dewayne57/Coil_Winder/Resources/Arduino-CNC-Shield-Schematics-V3.XX_.jpg

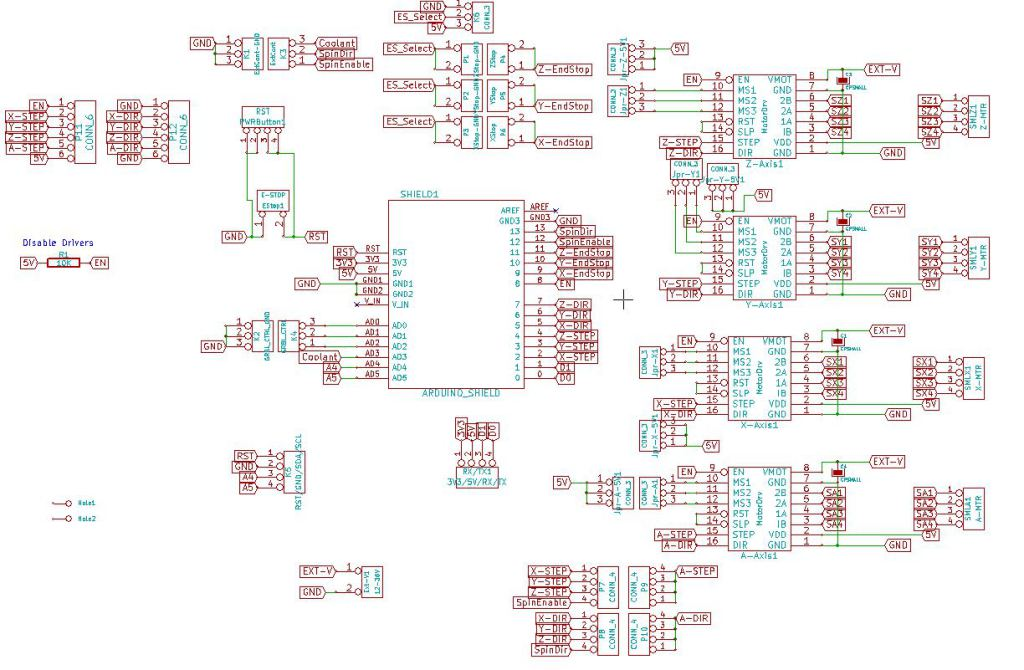
Resources/Arduino-CNC-Shield-Schematics-V3.XX_.jpg
