dewayne57/Coil_Winder/Resources/PH264M,PH265M,PH266M,PH268M.pdf

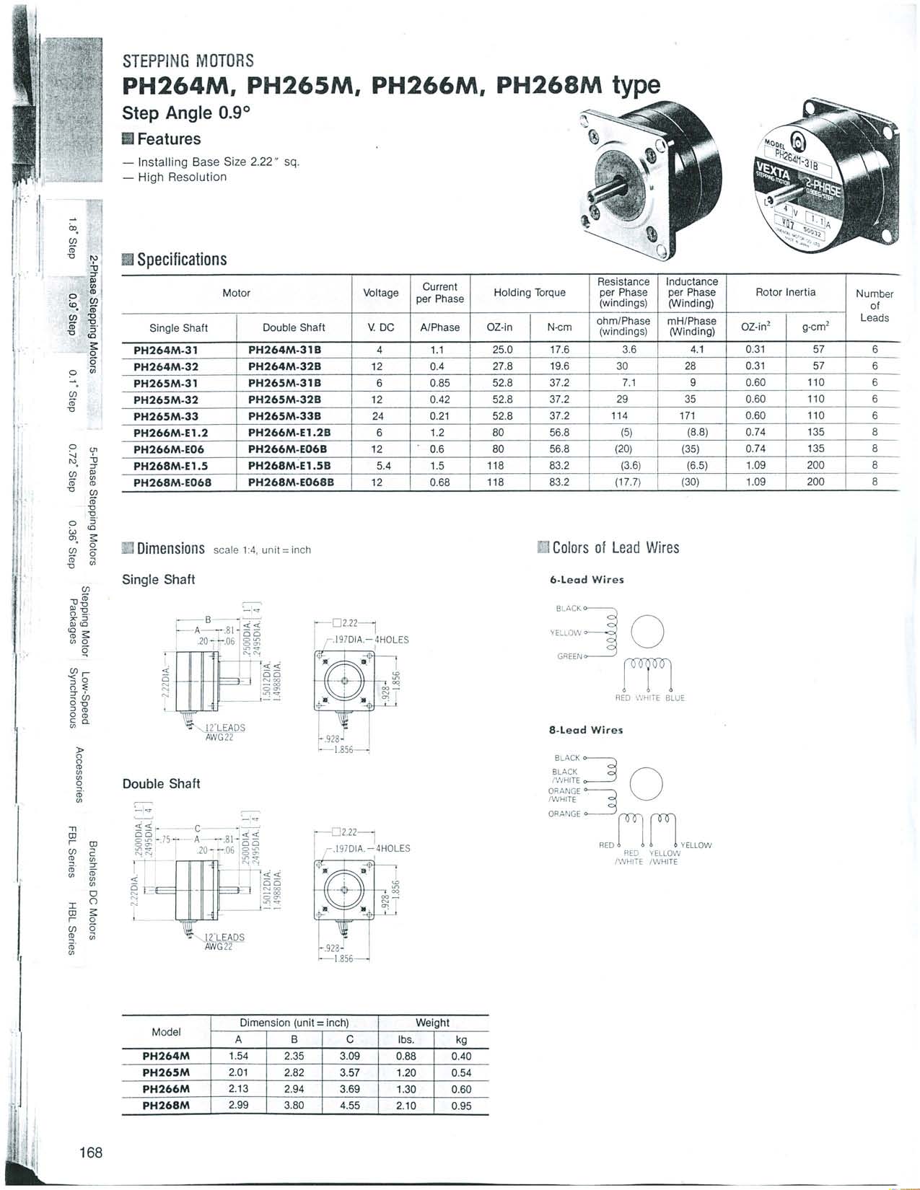
[picture p2: page 1]
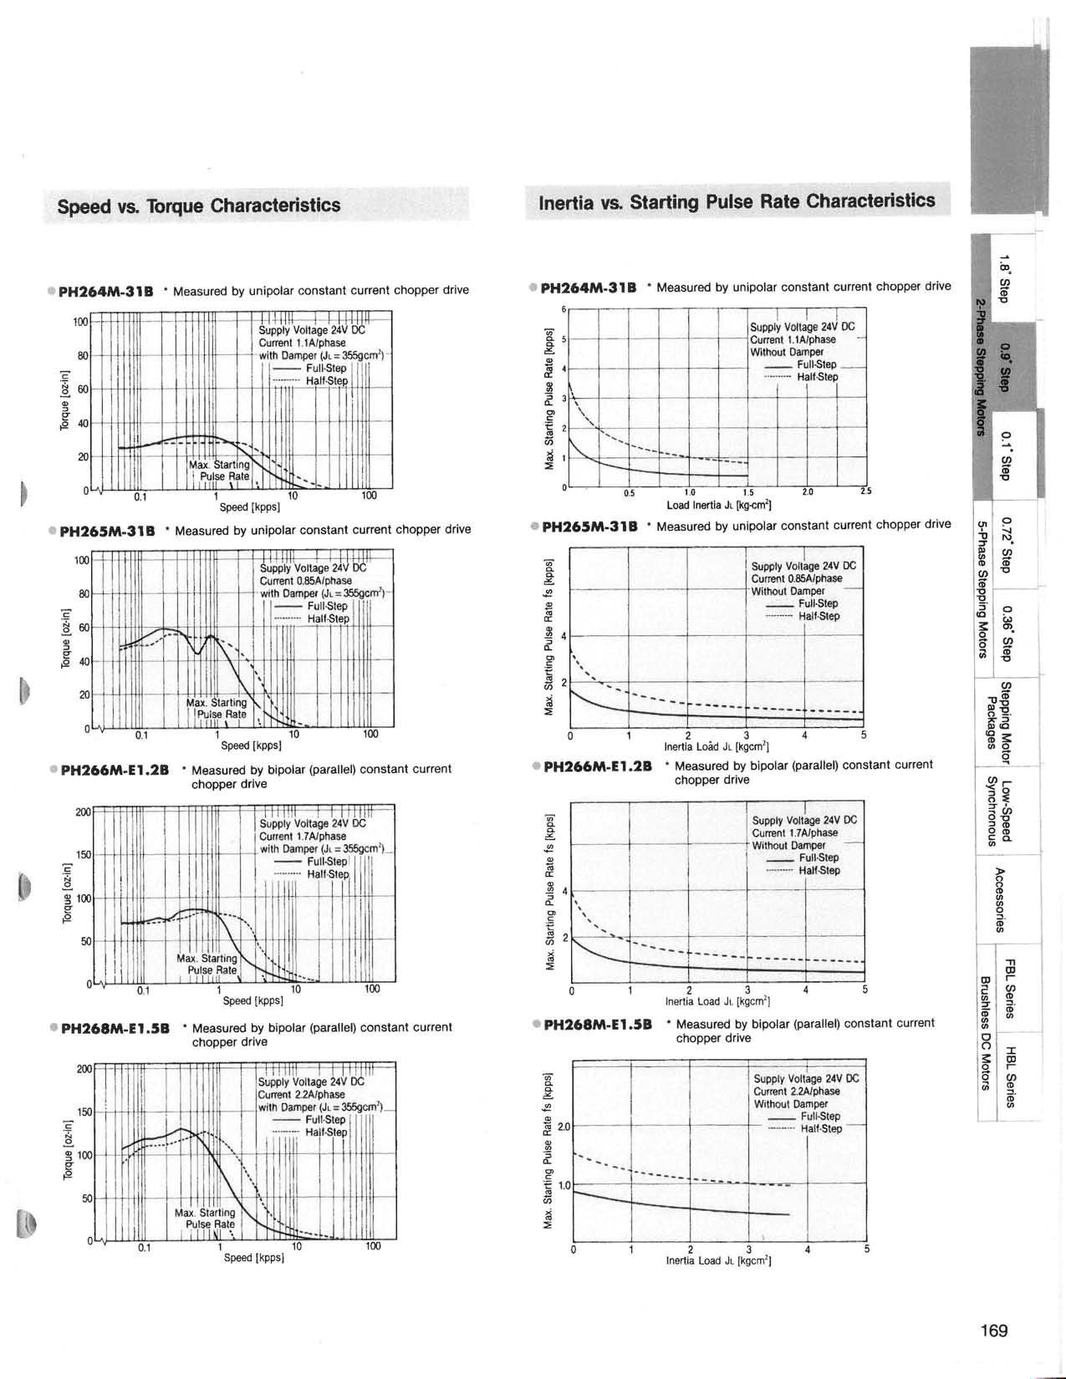
[picture p3: page 2]
