dewayne57/Coil_Winder/3D Models/Coil Winder Models-Tailstock.3mf

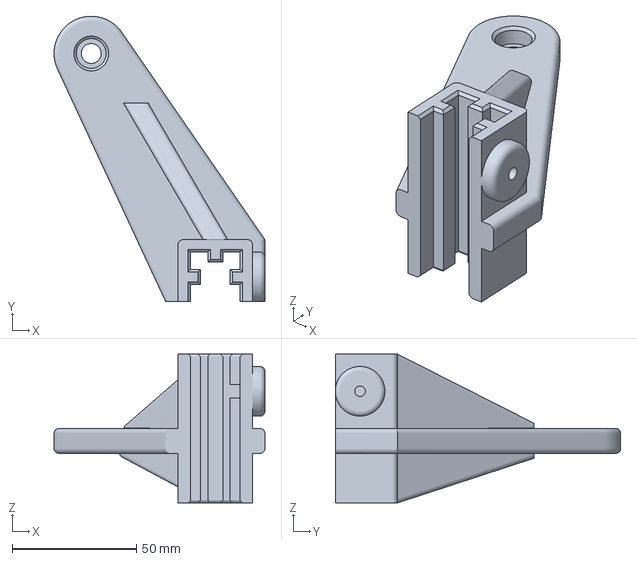
[picture p4: CAD file, 2026-11-14]
3D Models/Coil Winder Models-Tailstock.3mf
85.0 x 115.0 x 60.0 mm
