dewayne57/Coil_Winder/3D Models/Coil Winder Models.FCStd

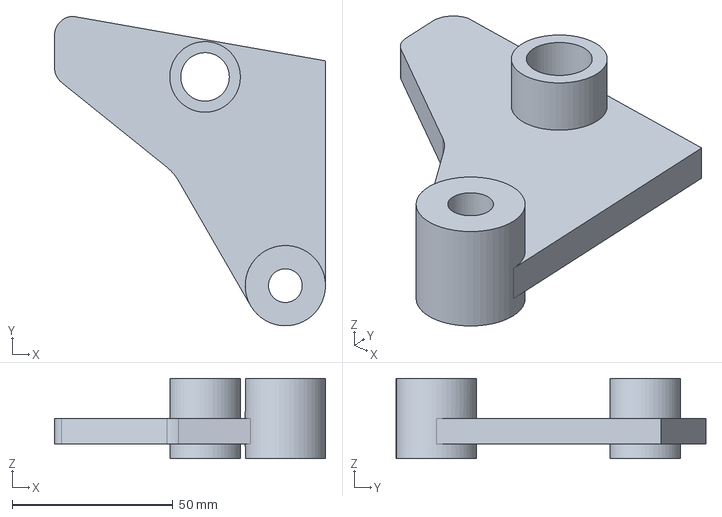
[picture p5: CAD file, 2026-11-14]
3D Models/Coil Winder Models.FCStd
84.4 x 96.4 x 25.0 mm
