dewayne57/Coil_Winder/3D Models/Coil Winder Models-Right End.3mf

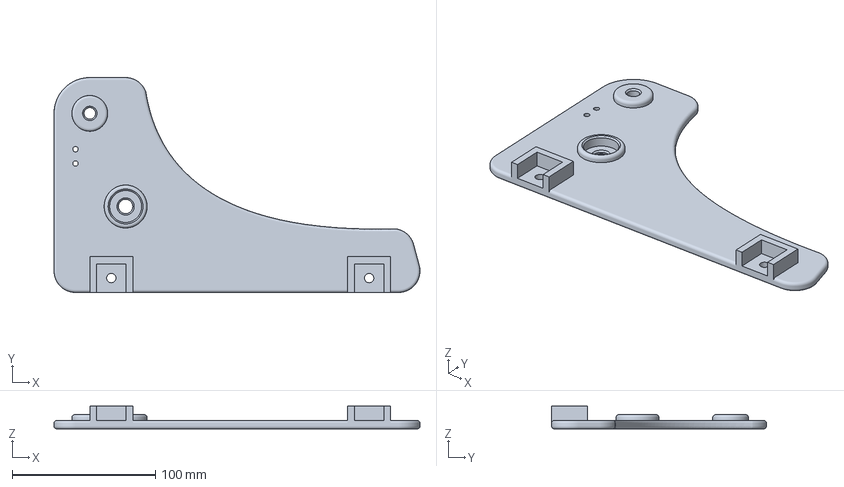
[picture p6: CAD file, 2026-11-14]
3D Models/Coil Winder Models-Right End.3mf
255.5 x 150.0 x 16.0 mm
