dewayne57/Coil_Winder/3D Models/Coil Winder Models-Left EndLeft End Body.3mf

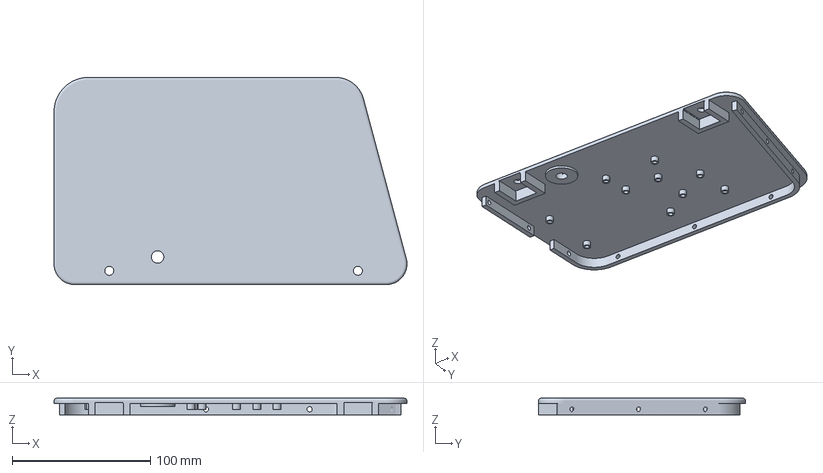
[picture p7: CAD file, 2026-11-13]
3D Models/Coil Winder Models-Left EndLeft End Body.3mf
255.5 x 150.0 x 12.0 mm
