dewayne57/Coil_Winder/3D Models/Coil Winder Models-Front Panel.3mf

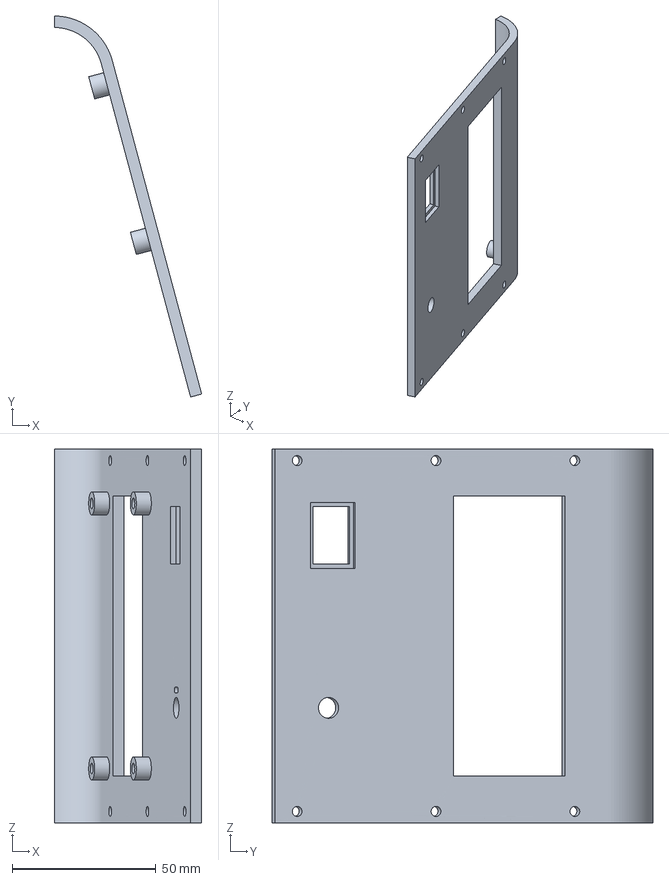
[picture p8: CAD file, 2026-11-13]
3D Models/Coil Winder Models-Front Panel.3mf
51.3 x 132.5 x 130.0 mm
