dewayne57/Coil_Winder/3D Models/Coil Winder Models-Motor End.3mf

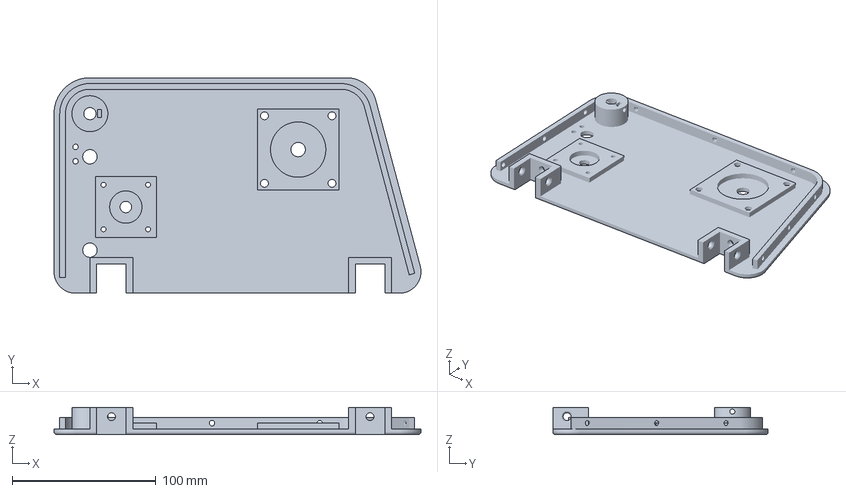
[picture p9: CAD file, 2026-11-13]
3D Models/Coil Winder Models-Motor End.3mf
255.5 x 150.0 x 19.0 mm
