dewayne57/Coil_Winder/3D Models/Coil Winder Models-Quarter Inch Drive Hub.3mf

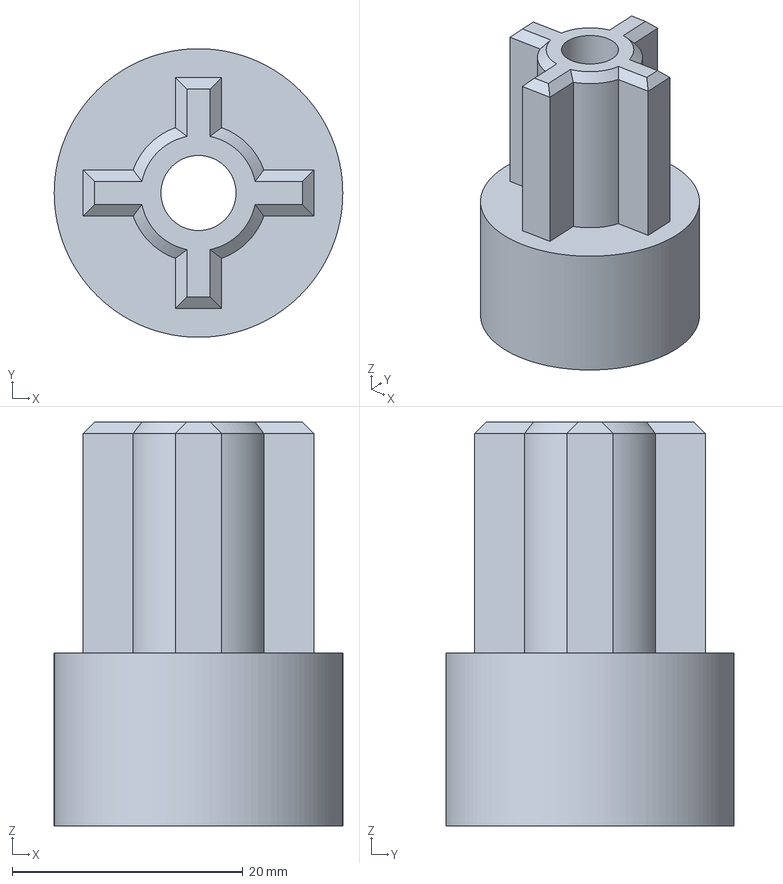
[picture p11: CAD file, 2026-11-13]
3D Models/Coil Winder Models-Quarter Inch Drive Hub.3mf
25.0 x 25.0 x 35.0 mm
