dewayne57/Coil_Winder/3D Models/Coil Winder Models-Large Rectangular Form Adapter.3mf

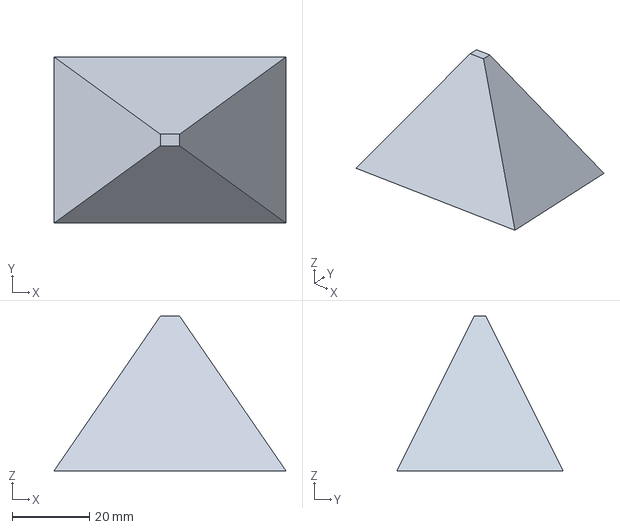
[picture p12: CAD file, 2026-11-13]
3D Models/Coil Winder Models-Large Rectangular Form Adapter.3mf
60.0 x 43.0 x 40.0 mm
