dewayne57/Coil_Winder/3D Models/Coil Winder Models-Large Wire Anchor.3mf

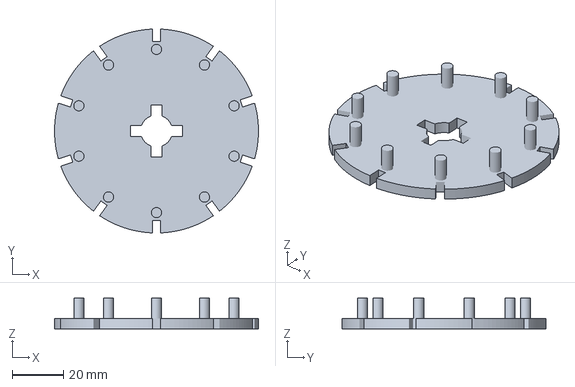
[picture p15: CAD file, 2026-11-10]
3D Models/Coil Winder Models-Large Wire Anchor.3mf
80.0 x 79.9 x 12.0 mm
