dewayne57/Coil_Winder/3D Models/Coil Winder Models-Left End Cover.3mf

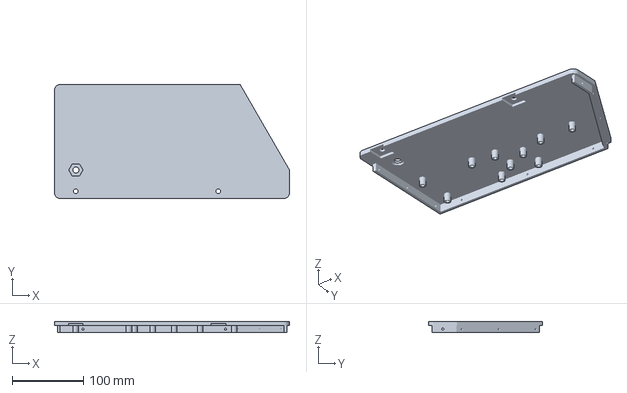
[picture p16: CAD file, 2026-11-09]
3D Models/Coil Winder Models-Left End Cover.3mf
330.0 x 160.0 x 16.0 mm
