dewayne57/Coil_Winder/3D Models/Coil Winder Models-Front Cover.3mf

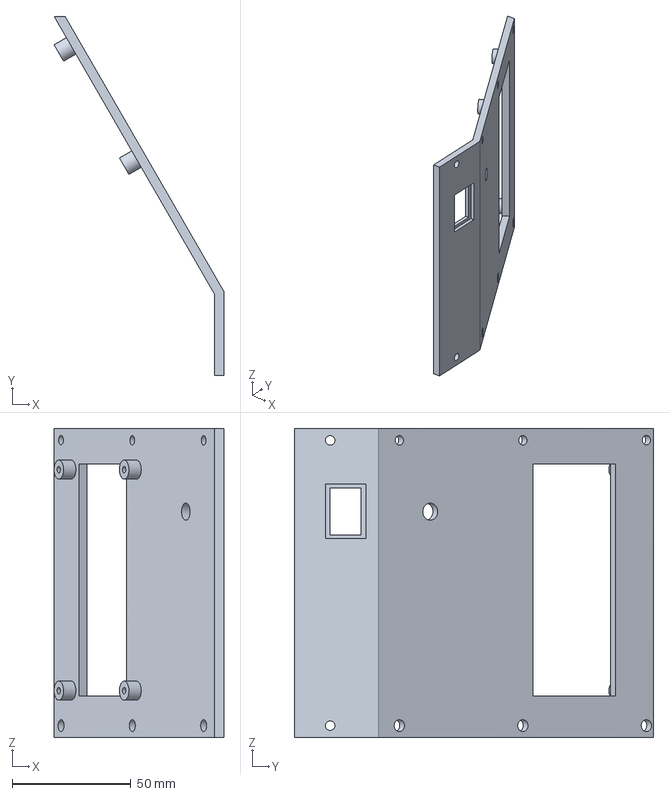
[picture p17: CAD file, 2026-11-09]
3D Models/Coil Winder Models-Front Cover.3mf
71.5 x 151.1 x 130.0 mm
