dewayne57/Coil_Winder/3D Models/Coil Winder.FCStd

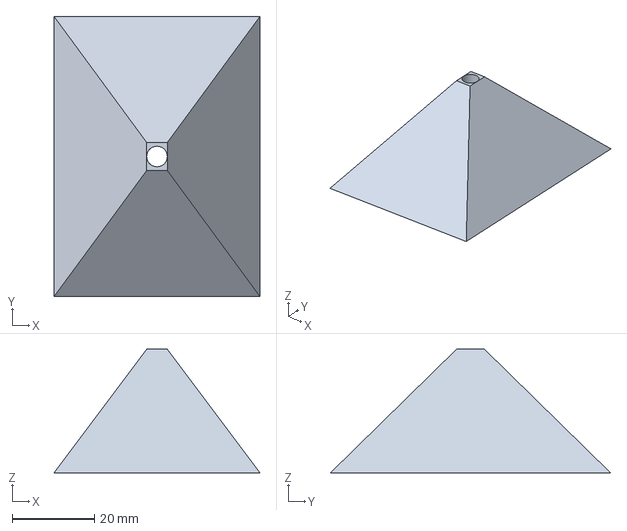
[picture p18: CAD file, 2026-11-02]
3D Models/Coil Winder.FCStd
50.0 x 68.0 x 30.0 mm
