dewayne57/Coil_Winder/3D Models/Coil Winder-Adapter.3mf

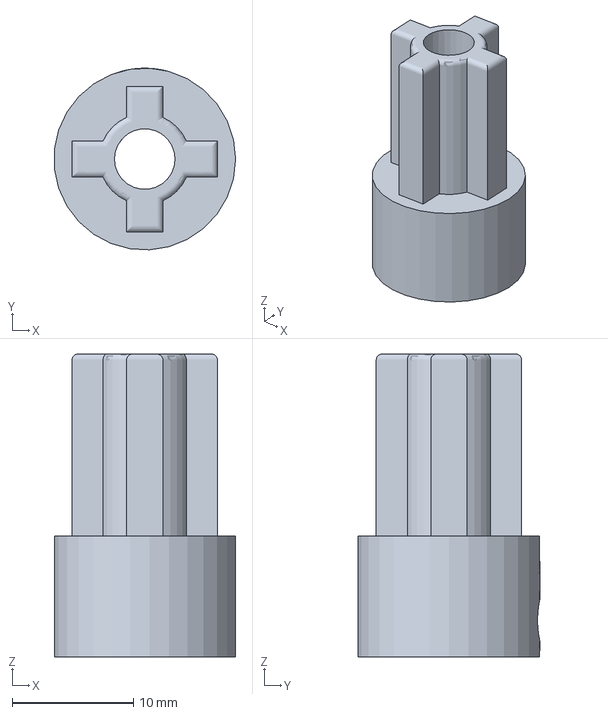
[picture p19: CAD file, 2026-11-02]
3D Models/Coil Winder-Adapter.3mf
15.0 x 15.0 x 25.0 mm
