dewayne57/Coil_Winder/3D Models/Coil Winder-Motor EndBody.3mf

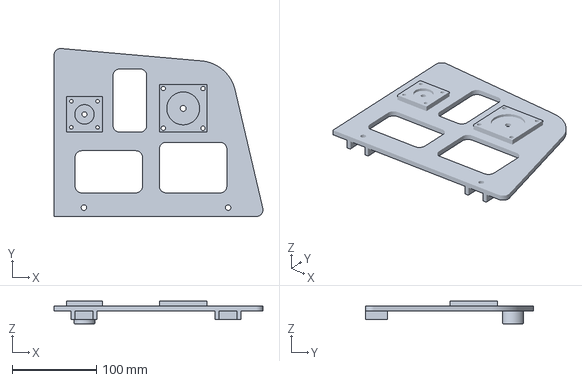
[picture p21: CAD file, 2026-11-02]
3D Models/Coil Winder-Motor EndBody.3mf
247.9 x 199.3 x 27.0 mm
