dewayne57/Coil_Winder/3D Models/Coil Winder-Wire Anchor.3mf

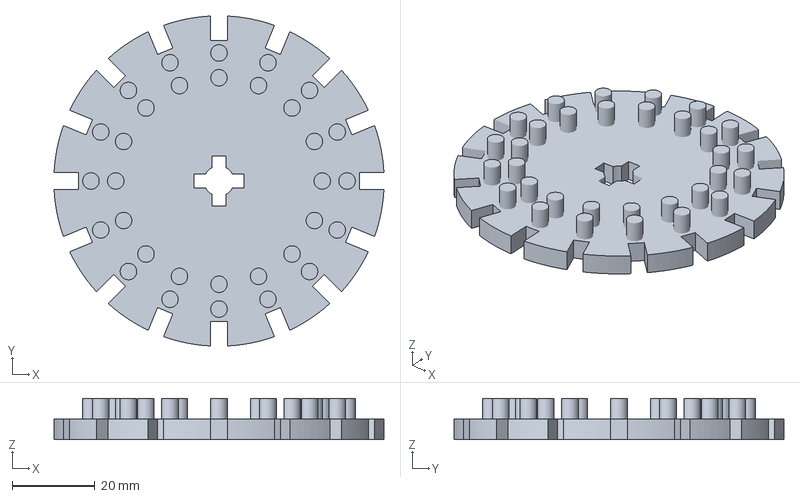
[picture p22: CAD file, 2026-11-02]
3D Models/Coil Winder-Wire Anchor.3mf
79.9 x 79.9 x 10.0 mm
