dewayne57/Coil_Winder/3D Models/Coil Winder-Wire Guide.3mf

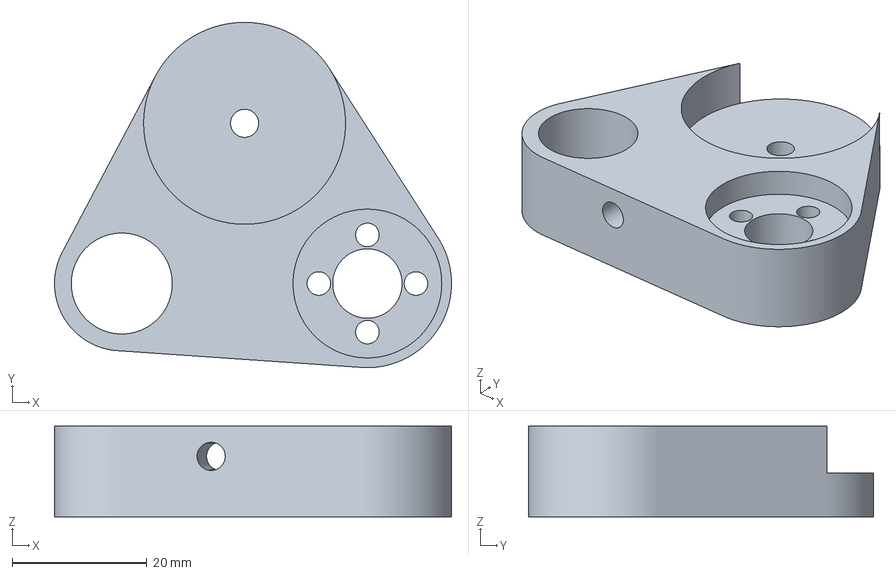
[picture p23: CAD file, 2026-11-02]
3D Models/Coil Winder-Wire Guide.3mf
59.0 x 51.3 x 13.5 mm
