dewayne57/Coil_Winder/3D Models/Coil Winder-6mm Adapter.3mf

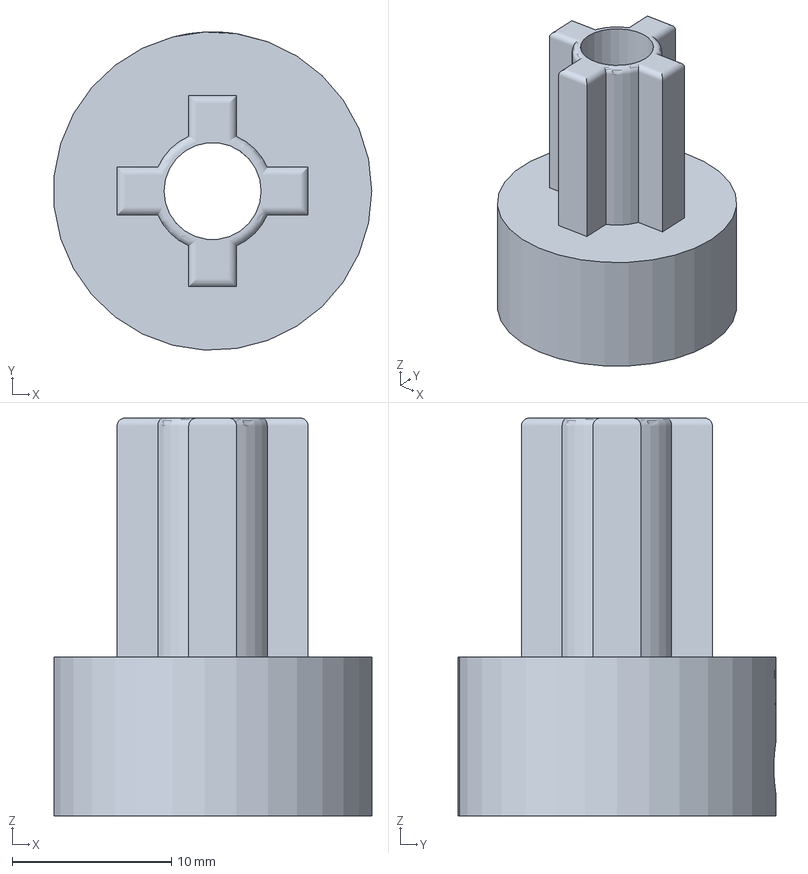
[picture p24: CAD file, 2026-11-02]
3D Models/Coil Winder-6mm Adapter.3mf
19.9 x 20.0 x 25.0 mm
