dewayne57/Coil_Winder/3D Models/Coil Winder-Tailstock.3mf

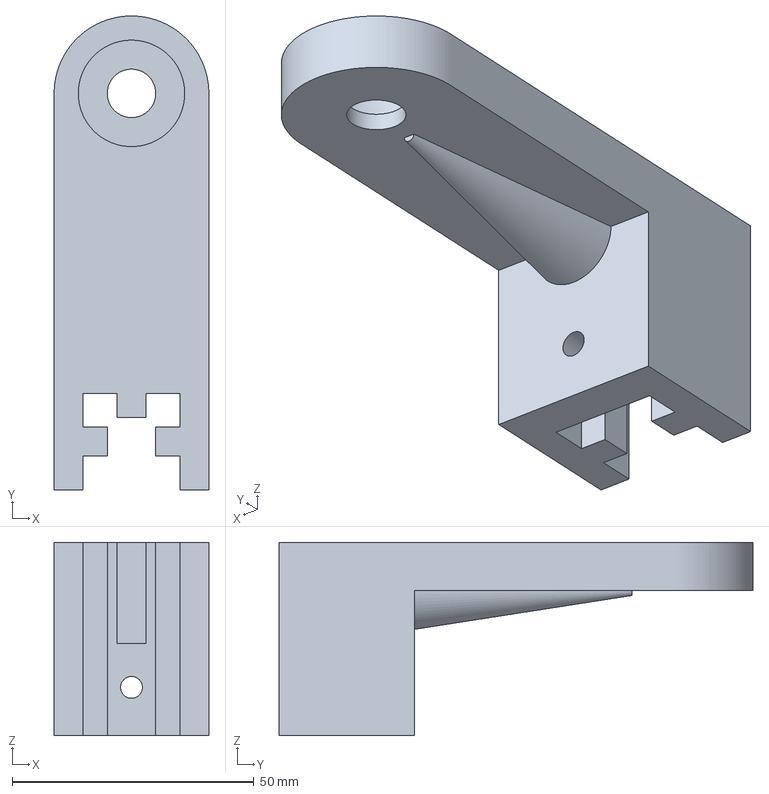
[picture p25: CAD file, 2026-11-02]
3D Models/Coil Winder-Tailstock.3mf
32.0 x 98.0 x 40.0 mm
