dewayne57/Coil_Winder/3D Models/Coil Winder-Winder End.3mf

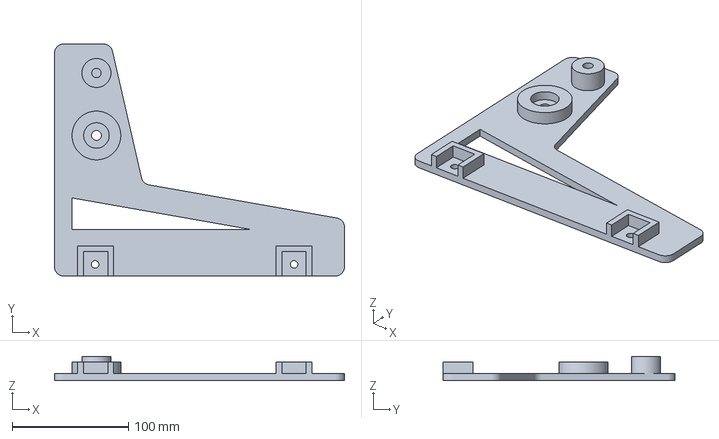
[picture p26: CAD file, 2026-11-02]
3D Models/Coil Winder-Winder End.3mf
250.0 x 200.0 x 21.0 mm
