dewayne57/Coil_Winder/(list of files, cad)

Other CAD files:
3D Models/Coil Winder Models-Left End.3mf
3D Models/Coil Winder Models-6mm Drive Hub.3mf
3D Models/Coil Winder-Rectangle Form Adapter.3mf
3D Models/Coil Winder Models.3mf
