dewayne57/Coil_Winder/Schematic/Coil Winder.kicad_sch

## KiCad design Schematic/Coil Winder.kicad_sch (2026-11-14)

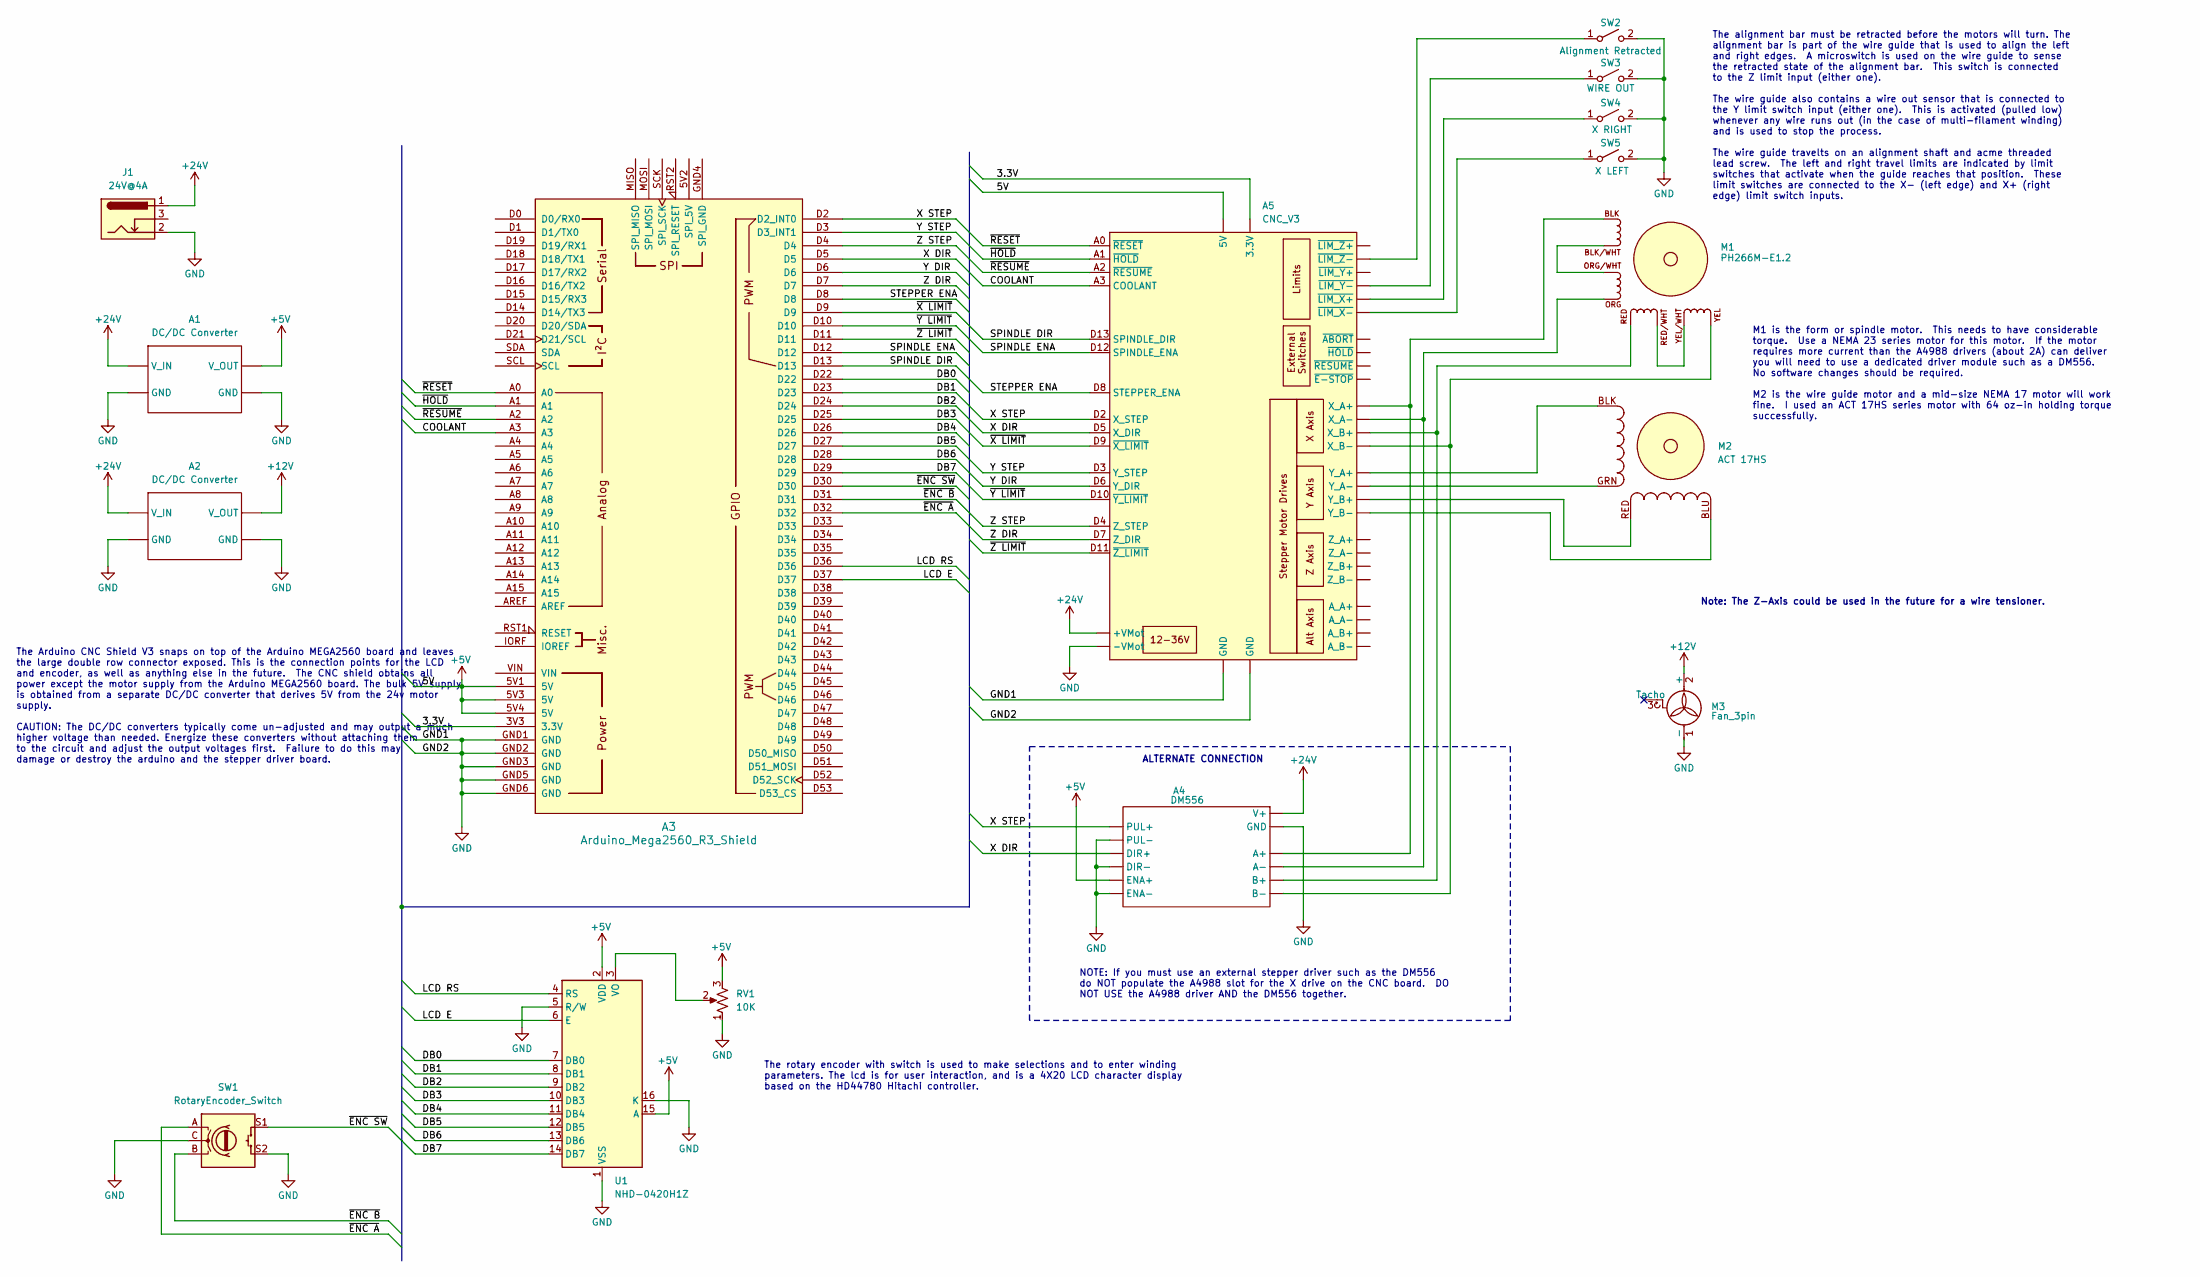
[picture p27: schematic Coil Winder.kicad_sch]

Parts:
A1, A2: DC/DC Converter
A3: Arduino_Mega2560_R3_Shield
A4: DM556
A5: CNC_V3
J1: 24V@4A
M1: PH266M-E1.2
M2: ACT 17HS
M3: Fan_3pin; PLCC-84_29.3x29.3mm_P1.27mm
RV1: 10K; TSSOP-20_4.4x6.5mm_P0.65mm
SW1: RotaryEncoder_Switch; QFN-28-1EP_6x6mm_P0.65mm_EP4.25x4.25mm
SW2: Alignment Retracted; SOIC-28W_7.5x17.9mm_P1.27mm
SW3: WIRE OUT; SOIC-28W_7.5x17.9mm_P1.27mm
SW4: X RIGHT; SOIC-28W_7.5x17.9mm_P1.27mm
SW5: X LEFT; SOIC-28W_7.5x17.9mm_P1.27mm
U1: NHD-0420H1Z

Connections:
3.3V: A3.3V3 (3.3V), A5. (+VMot)
+5V: A1., A3.5V1 (5V), A3.5V3 (5V), A3.5V4 (5V), A4., A5. (+VMot), RV1.3, U1.2 (VDD), U1.15 (A)
+12V: A2., M3.2 (+)
+24V: A1., A2., A4., A5. (+VMot), J1.1
COOLANT: A3.A3, A5.A3 (COOLANT)
DB0: A3.D22, U1.7 (DB0)
DB1: A3.D23, U1.8 (DB1)
DB2: A3.D24, U1.9 (DB2)
DB3: A3.D25, U1.10 (DB3)
DB4: A3.D26, U1.11 (DB4)
DB5: A3.D27, U1.12 (DB5)
DB6: A3.D28, U1.13 (DB6)
DB7: A3.D29, U1.14 (DB7)
GND: A1., A2., A3.GND1 (GND), A3.GND2 (GND), A3.GND3 (GND), A3.GND5 (GND), A3.GND6 (GND), A4., A5. (+VMot), J1.2, M3.1 (-), RV1.1, SW1.C, SW1.S2, SW2.2 (B), SW3.2 (B), SW4.2 (B), SW5.2 (B), U1.1 (VSS), U1.5 (R/W), U1.16 (K)
LCD E: A3.D37, U1.6 (E)
LCD RS: A3.D36, U1.4 (RS)
unnamed: A4., A5. (+VMot), M1.
unnamed: A5. (+VMot), M2.BLK, M2.BLU, M2.GRN, M2.RED, SW2.1 (A), SW3.1 (A), SW4.1 (A), SW5.1 (A)
unnamed: RV1.2, U1.3 (VO)
SPINDLE DIR: A3.D13, A5.D13 (SPINDLE_DIR)
SPINDLE ENA: A3.D12, A5.D12 (SPINDLE_ENA)
STEPPER ENA: A3.D8, A5.D8 (STEPPER_ENA)
X DIR: A3.D5, A4., A5.D5 (X_DIR)
X STEP: A3.D2 (D2_INT0), A4., A5.D2 (X_STEP)
Y DIR: A3.D6, A5.D6 (Y_DIR)
Y STEP: A3.D3 (D3_INT1), A5.D3 (Y_STEP)
Z DIR: A3.D7, A5.D7 (Z_DIR)
Z STEP: A3.D4, A5.D4 (Z_STEP)
~ENC A: A3.D32, SW1.A
~ENC B: A3.D31, SW1.B
~ENC SW: A3.D30, SW1.S1
~HOLD: A3.A1, A5.A1 (~HOLD)
~RESET: A3.A0, A5.A0 (~RESET)
~RESUME: A3.A2, A5.A2 (~RESUME)
~X LIMIT: A3.D9, A5.D9 (~X_LIMIT)
~Y LIMIT: A3.D10, A5.D10 (~Y_LIMIT)
~Z LIMIT: A3.D11, A5.D11 (~Z_LIMIT)

Notes on the sheet:
The Arduino CNC Shield V3 snaps on top of the Arduino MEGA2560 board and leaves the large double row connector exposed. This is the connection points for the LCD and encoder, as well as anything else in the future. The CNC shield obtains all power except the motor supply from the Arduino MEGA2560 b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
Note: The Z-Axis could be used in the future for a wire tensioner.
The alignment bar must be retracted before the motors will turn. The alignment bar is part of the wire guide that is used to align the left and right edges. A microswitch is used on the wire guide to sense the retracted state of the alignment bar. This switch is connected to the Z limit input (eith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
The rotary encoder with switch is used to make selections and to enter winding parameters. The lcd is for user interaction, and is a 4X20 LCD character display based on the HD44780 Hitachi controller.
M1 is the form or spindle motor. This needs to have considerable torque. Use a NEMA 23 series motor for this motor. If the motor requires more current than the A4988 drivers (about 2A) can deliver you will need to use a dedicated driver module such as a DM556. No software changes should be required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
NOTE: If you must use an external stepper driver such as the DM556 do NOT populate the A4988 slot for the X drive on the CNC board. DO NOT USE the A4988 driver AND the DM556 together.
ALTERNATE CONNECTION
