dewayne57/Coil_Winder/Firmware/config.h

/**
 * Coil_Winder Firmware
 *
 * Copyright (c) 2026 Dewayne L. Hafenstein
 *
 * This file is part of the Coil_Winder project.
 *
 * License: Coil_Winder Non-Commercial License
 * Permission is granted to use, copy, modify, and redistribute this
 * firmware for personal, educational, research, and non-commercial
 * purposes only.
 * Commercial use, including sale, manufacturing, sublicensing, or
 * distribution for direct or indirect financial gain, is prohibited
 * without a separate written commercial license from the copyright
 * holder.
 * Any modified or redistributed copies must retain this notice.
 * THE SOFTWARE IS PROVIDED "AS IS", WITHOUT WARRANTY OF ANY KIND,
 * EXPRESS OR IMPLIED, INCLUDING BUT NOT LIMITED TO THE WARRANTIES OF
 * MERCHANTABILITY, FITNESS FOR A PARTICULAR PURPOSE, AND
 * NONINFRINGEMENT. IN NO EVENT SHALL THE COPYRIGHT HOLDER BE LIABLE
 * FOR ANY CLAIM, DAMAGES, OR OTHER LIABILITY, WHETHER IN AN ACTION OF
 * CONTRACT, TORT OR OTHERWISE, ARISING FROM, OUT OF CONNECTION WITH
 * THE SOFTWARE OR THE USE OR OTHER DEALINGS IN THE SOFTWARE.
 */
#ifndef CONFIG_H
#define CONFIG_H

/* CNC Shield V3 pins (digital pins D0-D13 line up on Uno and Mega2560) */
#define X_STEP_PIN 2
#define X_DIR_PIN 5
#define STEPPER_EN_PIN 8 /* shared enable, active LOW */

/* X+ and X- headers on the CNC Shield V3 share one net: X-EndStop = D9.
 * The hit end is inferred from the direction of travel.
 */
#define X_LIMIT_PIN 9
#define Y_LIMIT_PIN 10 /* wire-out sensor, active when a wire runs out */
#define Z_LIMIT_PIN 11 /* alignment-bar retract sensor, active when the bar is not retracted */

/* Limit switches use INPUT_PULLUP. Normally-open to GND => triggered
 * when LOW. Set to HIGH for normally-closed switches.
 */
#define LIMIT_TRIGGERED_LEVEL LOW

/* Level on DIR pin that moves the carriage to the right (toward X+).
 * Swap HIGH/LOW if it runs the wrong way.
 */
#define X_DIR_RIGHT_LEVEL LOW

/* Y axis = form spindle (no limit switches) */
#define Y_STEP_PIN 3
#define Y_DIR_PIN 6

/* Level on DIR pin for "forward" spindle rotation */
#define Y_DIR_FWD_LEVEL HIGH

/* Steps are generated by a Timer1 interrupt at this rate (max step rate
 * per axis is well below it).
 */
#define STEP_TICK_HZ 20000UL

/* Driver microstepping per axis (must match each driver's MS jumpers):
 * 1, 2, 4, 8, 16
 */
#define X_MICROSTEPS 8UL
#define Y_MICROSTEPS 4UL

/* X traverse speed, in full steps per second (400 = 2 rev/s on a
 * 200-step motor).
 */
#define X_FULLSTEPS_PER_SEC 400UL
#define X_STEP_RATE_SPS (X_FULLSTEPS_PER_SEC * X_MICROSTEPS)

#define LIMIT_DEBOUNCE_MS 5UL

/* X homing: seek left (X-) slowly, back off until released, then clear
 * the switch by a margin.
 */
#define HOME_SEEK_FULLSTEPS_PER_SEC 200UL
#define HOME_SEEK_RATE_SPS (HOME_SEEK_FULLSTEPS_PER_SEC * X_MICROSTEPS)
#define HOME_SEEK_MAX_STEPS 400000L /* give up if no limit found (fault) */
#define HOME_BACKOFF_MAX_STEPS 3200L /* max travel while releasing a switch */
#define HOME_CLEARANCE_STEPS 800L    /* extra travel after release; this point is X = 0 */
#define SERIAL_BAUD 115200

/* 20x4 HD44780 LCD, 8-bit parallel (RW tied low; VSS/K to GND, VDD/A to
 * 5V, V0 to contrast pot). LCD E/RS are on PC0/PC1 to allow fast port-level
 * toggles; the data bus is on PE0..PE7.
 */
#define LCD_RS_PIN 36 /* PC1 */
#define LCD_EN_PIN 37 /* PC0 */
#define LCD_D0_PIN 24 /* PE0 */
#define LCD_D1_PIN 25 /* PE1 */
#define LCD_D2_PIN 26 /* PE2 */
#define LCD_D3_PIN 27 /* PE3 */
#define LCD_D4_PIN 28 /* PE4 */
#define LCD_D5_PIN 29 /* PE5 */
#define LCD_D6_PIN 30 /* PE6 */
#define LCD_D7_PIN 31 /* PE7 */
#define LCD_COLS 20
#define LCD_ROWS 4

/* Rotary encoder with push button (common pin to GND, internal pull-ups used).
 * Phase A/B/SW are grouped on PC5/PC6/PC7 so the read path can use PINC directly.
 */
#define ENC_A_PIN 32                 /* PC5 */
#define ENC_B_PIN 31                 /* PC6 */
#define ENC_SW_PIN 30                /* PC7 */
#define ENC_TRANSITIONS_PER_DETENT 4 /* use 2 if one click skips counts */
#define ENC_BUTTON_DEBOUNCE_MS 20UL
#define ENC_LONG_PRESS_MS 800UL

/* Jogging the wire guide to set the coil edges (positions are in
 * microsteps from home).
 */
#define JOG_STEPS_PER_DETENT (X_MICROSTEPS * 2UL) /* 2 full steps per click */
#define JOG_FULLSTEPS_PER_SEC 200UL
#define JOG_Y_STEPS_PER_DETENT (Y_MICROSTEPS * 4UL) /* 4 full steps (7.2 deg) per click */
#define JOG_Y_RATE_SPS (100UL * Y_MICROSTEPS)
#define JOG_RATE_SPS (JOG_FULLSTEPS_PER_SEC * X_MICROSTEPS)
#define MIN_COIL_WIDTH_STEPS (X_MICROSTEPS * 4UL)

/* X mechanics: 4-start acme lead screw, 8 mm travel per motor revolution */
#define X_FULL_STEPS_PER_REV 200UL
#define X_LEAD_MM 8UL
#define X_USTEPS_PER_MM ((float)(X_FULL_STEPS_PER_REV * X_MICROSTEPS) / (float)X_LEAD_MM)
#define ALIGNMENT_BAR_WIDTH_MM 4.0f
#define ALIGNMENT_BAR_WIDTH_STEPS ((long)(ALIGNMENT_BAR_WIDTH_MM * X_USTEPS_PER_MM + 0.5f))

/* Spindle (Y) is direct drive */
#define Y_STEPS_PER_REV (MOTOR_FULL_STEPS_PER_REV * Y_MICROSTEPS)

/* Highest X step rate allowed while winding; the spindle is slowed if a
 * pattern needs more.
 */
#define X_MAX_STEP_RATE_SPS 3200UL

/* Wire settings */
#define WIRE_AWG_MIN 18
#define WIRE_AWG_MAX 60
#define WIRE_MIN_UM 5
#define WIRE_MAX_UM 1500

/* Enamel build added to the bare AWG diameter (percent). Set 0 to use bare diameter. */
#define WIRE_INSULATION_PERCENT 5
#define TURNS_MAX 99999L
#define TURNS_DEFAULT 500L

/* Universal winding: quarter-revolutions per full traverse cycle (13 = 3.25 revs) */
#define UNIV_QUARTERS_MIN 6
#define UNIV_QUARTERS_MAX 80
#define UNIV_QUARTERS_DEFAULT 13

/* Scramble: max random guide movement per revolution, in wire pitches */
#define SCRAMBLE_MAX_PITCHES 3.0f

/* Spindle speed adjustment from the encoder (units of 0.1 rev/s) */
#define MOTOR_FULL_STEPS_PER_REV 200UL
#define Y_SPEED_MIN_TENTHS_RPS 5
#define Y_SPEED_MAX_TENTHS_RPS 25
#define Y_SPEED_DEFAULT_TENTHS_RPS 20

#endif
