dewayne57/Coil_Winder/(commit log)

2026-09-09 feat: add Arduino Mega coil winder menu sketch
2026-11-11 Clean up and redesigned motor end
2026-11-11 Added motor and left ends, front panel
2026-11-12 forgot wire pass throughs
